EmilAltmann/mcgol/hardware/cad/Cway Test Jig_.3mf

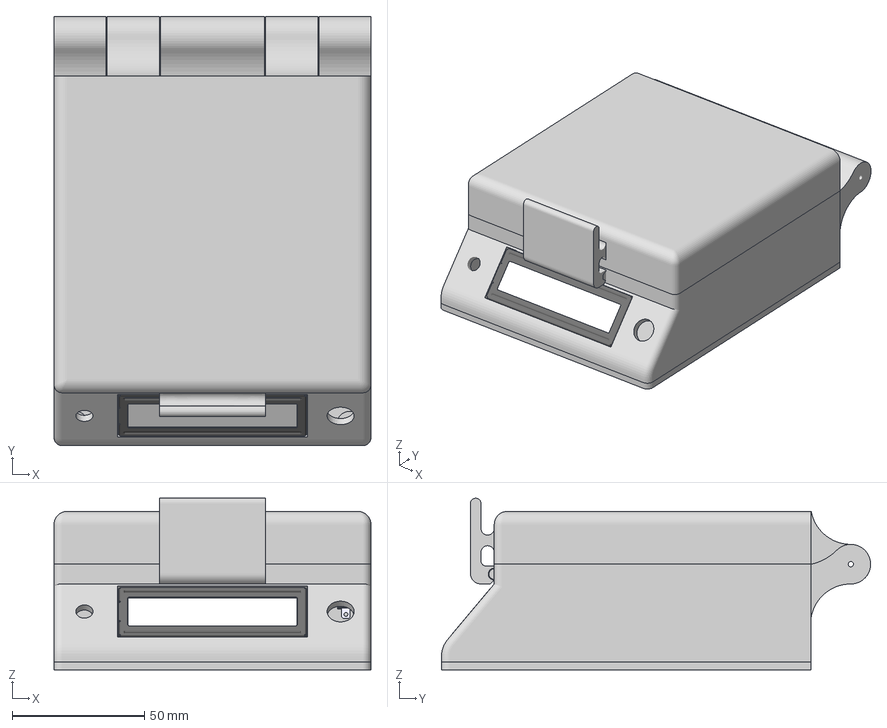
[picture p2: CAD file, 2026-10-28]
hardware/cad/Cway Test Jig_.3mf
120.0 x 162.5 x 65.0 mm
Körper1 x 926
Körper10 x 7
Körper11 x 7
Körper12 x 7
Körper13 x 7
Körper14 x 7
Körper15 x 7
Körper16 x 7
Körper17 x 5
Körper18 x 3
Körper19 x 3
Körper2 x 10
Körper20 x 3
Körper21 x 3
Körper22 x 3
Körper23 x 3
Körper24 x 3
Körper25 x 3
Körper26 x 3
Körper27 x 3
Körper28 x 3
Körper29 x 3
Körper3 x 10
Körper30 x 3
Körper31 x 3
Körper32 x 3
Körper33 x 3
Körper34 x 3
Körper35 x 2
Körper36 x 2
Körper37 x 2
Körper38 x 2
Körper39 x 2
Körper4 x 9
Körper40 x 2
Körper41 x 2
Körper42 x 2
Körper43 x 2
Körper44 x 2
Körper45 x 2
Körper46 x 2
Körper47 x 2
Körper48 x 2
Körper49 x 2
Körper5 x 8
Körper50 x 2
Körper51 x 2
Körper52 x 2
Körper53 x 2
Körper54 x 2
Körper55 x 2
Körper56 x 2
Körper57
Körper58
Körper59
Körper6 x 7
Körper60
Körper61
Körper62
Körper63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
