EmilAltmann/mcgol/hardware/pcb/CWOLv2.kicad_pcb

## KiCad design hardware/pcb/CWOLv2.kicad_pcb (2026-10-28)

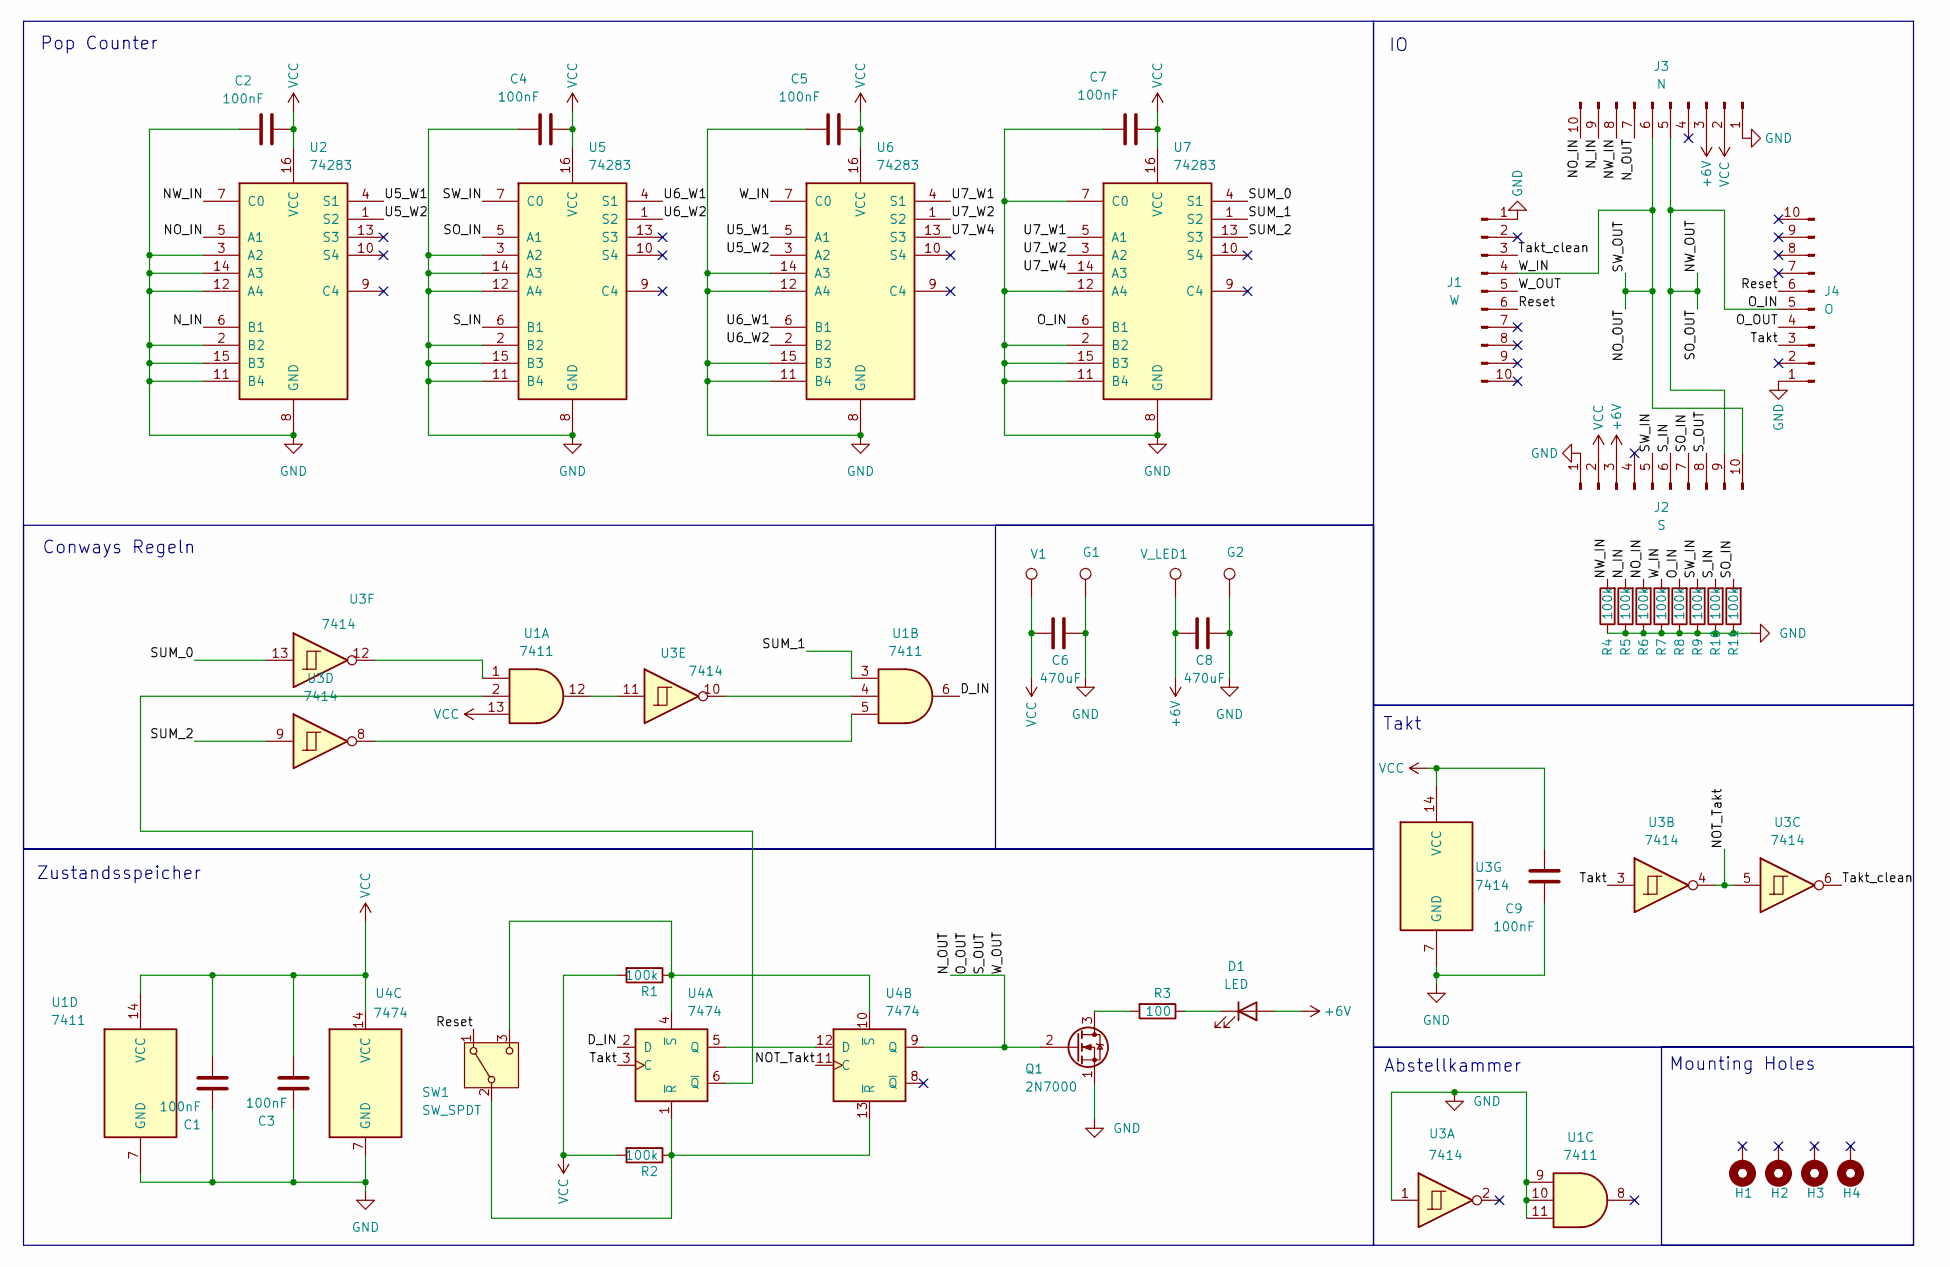
[picture p3: schematic CWOLv2.kicad_sch, Conways Game of Life]

Parts:
C1, C2, C3, C4, C5, C7, C9: 100nF; C_Disc_D5.0mm_W2.5mm_P2.50mm_3PIN
C6, C8: 470uF; CP_Radial_D5.0mm_P2.50mm
D1: LED; LED_D20.0mm
G1, G2: TestPoint; TestPoint_THTPad_D3.0mm_Drill1.5mm
H1, H2, H3, H4: MountingHole_Pad; MountingHole_3.2mm_M3_Pad_Via
J1: W; PinHeader_1x10_P2.54mm_Horizontal
J2: S; PinHeader_1x10_P2.54mm_Horizontal
J3: N; PinSocket_1x10_P2.54mm_Horizontal
J4: O; PinSocket_1x10_P2.54mm_Horizontal
Q1: 2N7000; TO-92_Inline_Wide
R1, R2, R4, R5, R6, R7, R8, R9, R10, R11: 100k; R_Axial_DIN0207_L6.3mm_D2.5mm_P10.16mm_Horizontal_Fett3
R3: 100; R_Axial_DIN0207_L6.3mm_D2.5mm_P10.16mm_Horizontal_Fett2
SW1: SW_SPDT; SW_Slide-03_Wuerth-WS-SLTV_10x2.5x6.4_P2.54mm
U1: 7411; DIP-14_W7.62mm_Socket_LongPads
U2, U5, U6, U7: 74283; DIP-16_W7.62mm_Socket_LongPads
U3: 7414; DIP-14_W7.62mm_Socket_LongPads
U4: 7474; DIP-14_W7.62mm_Socket_LongPads
V1: TestPoint; TestPoint_THTPad_D3.0mm_Drill1.5mm
V_LED1: TestPoint; TestPoint_THTPad_D3.0mm_Drill1.5mm

Connections:
+6V: C8.1, D1.2 (A), J2.3, J3.3, V_LED1.1 (1_1)
/D_IN: U1.6, U4.2 (D)
/NOT_Takt: U3.4, U3.5, U4.11 (C)
/NO_IN: J3.10, R6.2, U2.5 (A1)
/NO_OUT: J1.4, J2.10, J3.6, R7.2, U6.7 (C0)
/NW_IN: J3.8, R4.2, U2.7 (C0)
/NW_OUT: J2.9, J3.5, J4.5, R8.2, U7.6 (B1)
/N_IN: J3.9, R5.2, U2.6 (B1)
/N_OUT: J1.5, J2.8, J3.7, J4.4, Q1.2 (G), U4.9 (Q)
/Reset: J1.6, J4.6, SW1.1 (A)
/SO_IN: J2.7, R11.2, U5.5 (A1)
/SUM_0: U3.13, U7.4 (S1)
/SUM_1: U1.3, U7.1 (S2)
/SUM_2: U3.9, U7.13 (S3)
/SW_IN: J2.5, R9.2, U5.7 (C0)
/S_IN: J2.6, R10.2, U5.6 (B1)
/Takt: J4.3, U3.3, U4.3 (C)
/Takt_clean: J1.3, U3.6
/U5_W1: U2.4 (S1), U6.5 (A1)
/U5_W2: U2.1 (S2), U6.3 (A2)
/U6_W1: U5.4 (S1), U6.6 (B1)
/U6_W2: U5.1 (S2), U6.2 (B2)
/U7_W1: U6.4 (S1), U7.5 (A1)
/U7_W2: U6.1 (S2), U7.3 (A2)
/U7_W4: U6.13 (S3), U7.14 (A3)
GND: C1.1, C2.1, C3.1, C4.1, C5.1, C6.2, C7.1, C8.2, C9.1, G1.1 (1_1), G2.1 (1_1), J1.1, J2.1, J3.1, J4.1, Q1.1 (S), R4.1, R5.1, R6.1, R7.1, R8.1, R9.1, R10.1, R11.1, U1.7 (GND), U1.9, U1.10, U1.11, U2.2 (B2), U2.3 (A2), U2.8 (GND), U2.11 (B4), U2.12 (A4), U2.14 (A3), U2.15 (B3), U3.1, U3.7 (GND), U4.7 (GND), U5.2 (B2), U5.3 (A2), U5.8 (GND), U5.11 (B4), U5.12 (A4), U5.14 (A3), U5.15 (B3), U6.8 (GND), U6.11 (B4), U6.12 (A4), U6.14 (A3), U6.15 (B3), U7.2 (B2), U7.7 (C0), U7.8 (GND), U7.11 (B4), U7.12 (A4), U7.15 (B3)
unnamed: D1.1 (K), R3.1
unnamed: Q1.3 (D), R3.2
unnamed: R2.1, SW1.2 (B), U4.1 (~R), U4.13 (~R)
unnamed: R1.1, SW1.3 (C), U4.4 (~S), U4.10 (~S)
unnamed: U1.1, U3.12
unnamed: U1.4, U3.10
unnamed: U1.5, U3.8
unnamed: U1.12, U3.11
unnamed: U4.5 (Q), U4.12 (D)
unnamed: U1.2, U4.6 (~Q)
VCC: C1.2, C2.2, C3.2, C4.2, C5.2, C6.1, C7.2, C9.2, J2.2, J3.2, R1.2, R2.2, U1.13, U1.14 (VCC), U2.16 (VCC), U3.14 (VCC), U4.14 (VCC), U5.16 (VCC), U6.16 (VCC), U7.16 (VCC), V1.1 (1_1)

Notes on the sheet:
Pop Counter
Zustandsspeicher
Conways Regeln
Abstellkammer
Takt
Mounting Holes

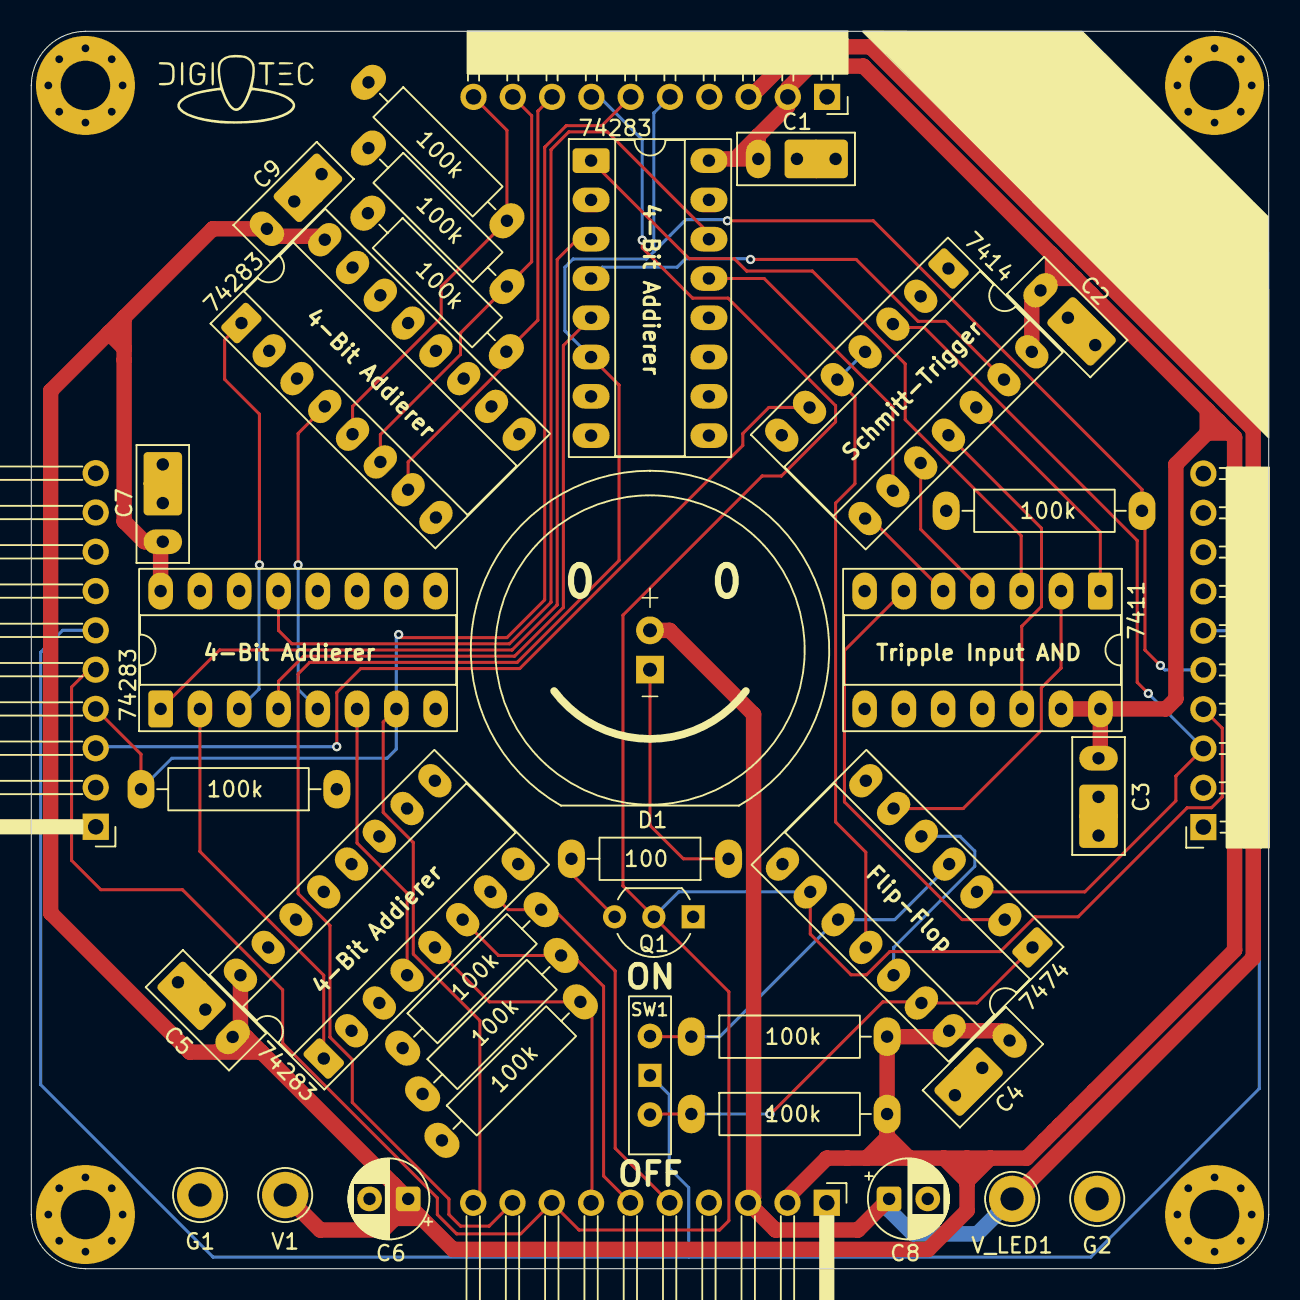
[picture p4: board CWOLv2.kicad_pcb from above]

Board: 2 copper layers, 80.0 x 80.0 mm, 42 parts (0 on the bottom side), 37 nets.
