EmilAltmann/mcgol/(commit log)

2026-10-28 Platinen Design Dateien
    [CWOLv2.kicad_pcb, CWOLv2.kicad_sch]
2026-10-28 CAD Test Jig Datei
    [Cway Test Jig_.3mf]
2026-10-28 docs: reorganize repository and add German project start page
    [CWOLv2.kicad_pcb, CWOLv2.kicad_sch, Cway Test Jig_.3mf]
