EmilAltmann/mcgol/plakat.png

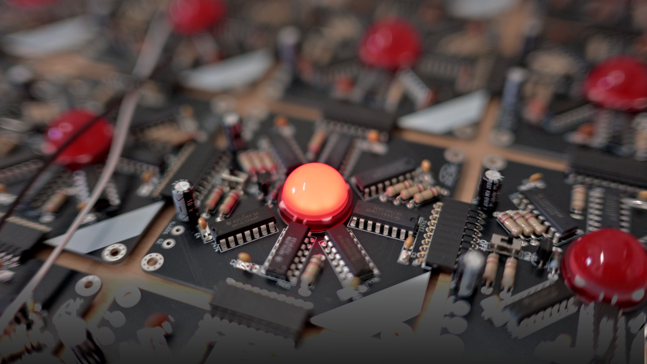
[picture p1: plakat.png]
plakat.png
